yigitakyol1/EE463-Hardware-Project-Team-5/final_report_figures/D1_output1.png

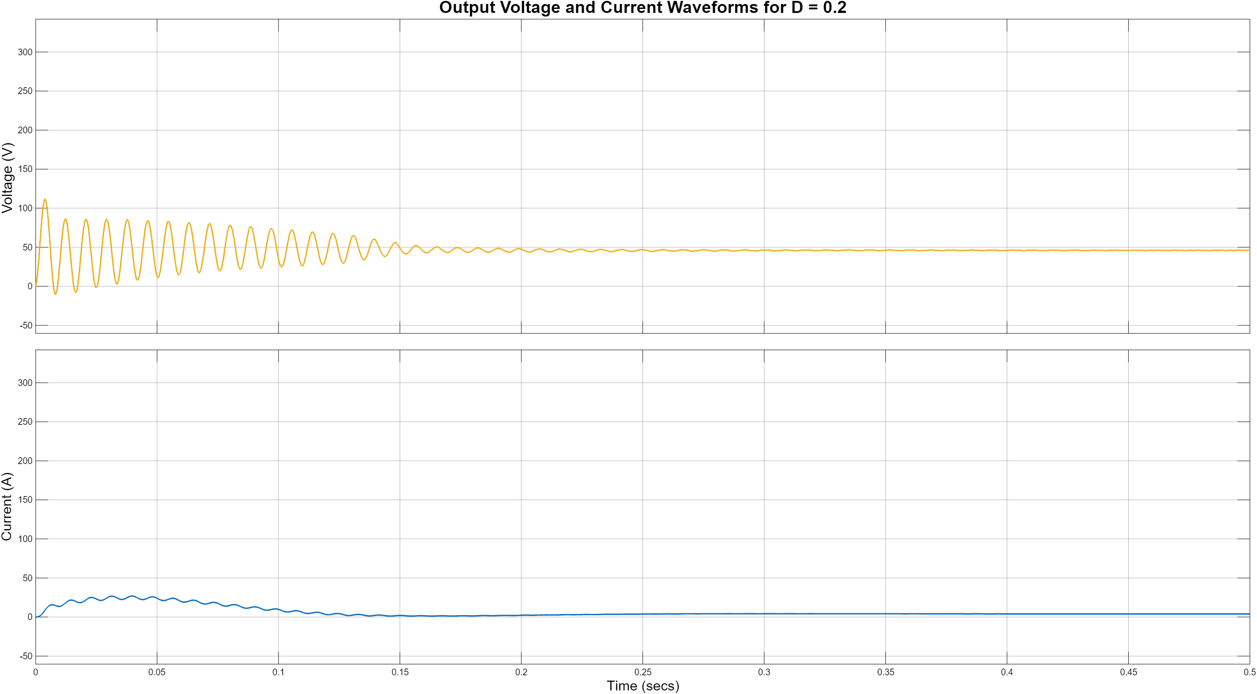
final_report_figures/D1_output1.png
