yigitakyol1/EE463-Hardware-Project-Team-5/final_report_figures/D2_output.png

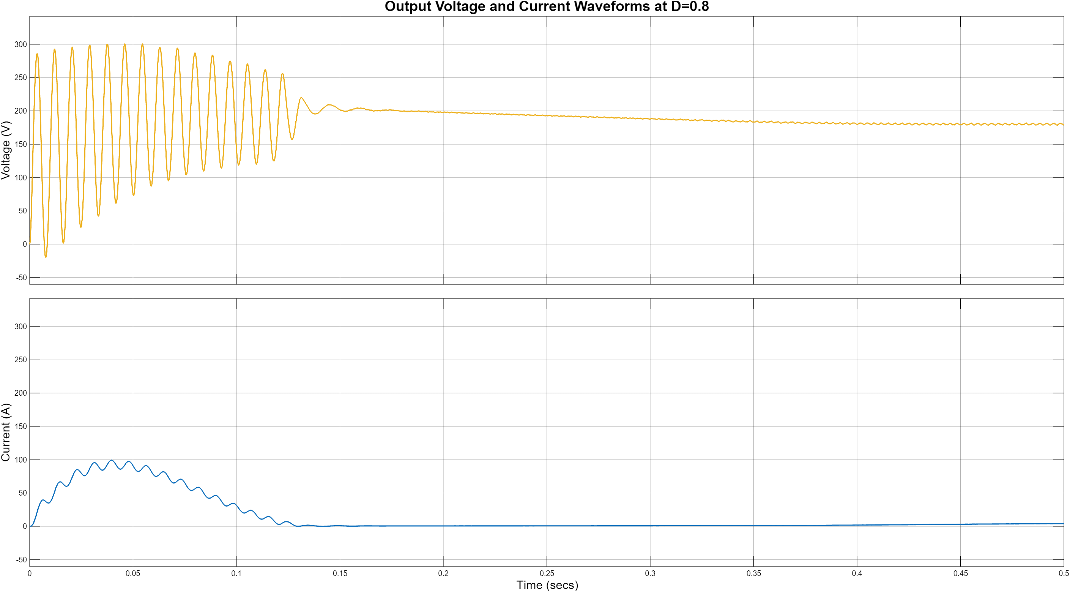
final_report_figures/D2_output.png
