yigitakyol1/EE463-Hardware-Project-Team-5/final_report_figures/IGBT_D2_SS.png

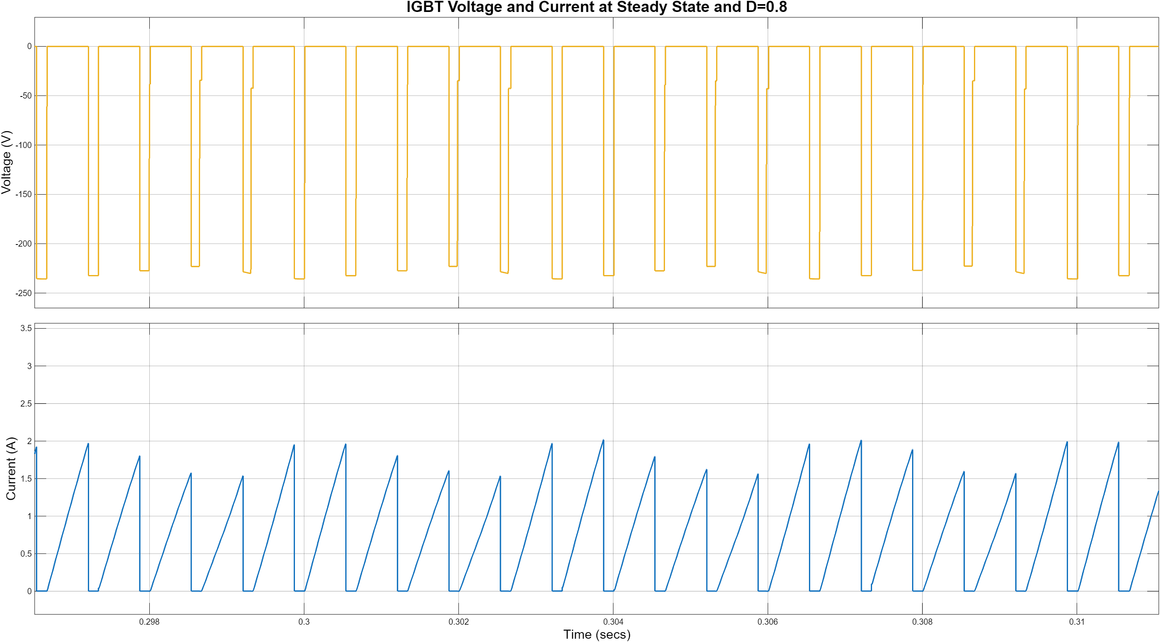
final_report_figures/IGBT_D2_SS.png
