yigitakyol1/EE463-Hardware-Project-Team-5/final_report_figures/IGBT_T_D1.png

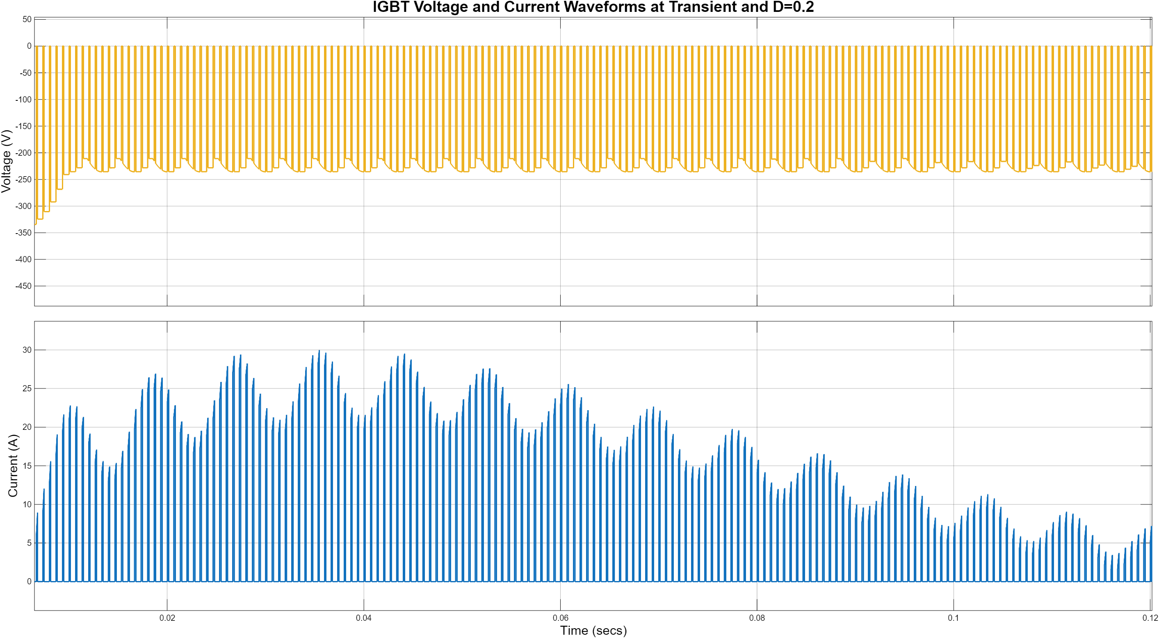
final_report_figures/IGBT_T_D1.png
