yigitakyol1/EE463-Hardware-Project-Team-5/component selection.docx

4. Component Selection

This section presents the selection of the main hardware components used in the rectifier and buck converter stages. For each element, simulation results were evaluated together with analytical requirements, and components were chosen to ensure stable operation during startup, transient behavior, and steady-state load.

4.1 Rectifier

To generate the required DC-link voltage for the buck converter, a three-phase diode bridge rectifier is used. Simulation results show an average output voltage of approximately 225 V with ripple around 40 V when the input phase voltage is 136.1 V RMS.

Key Calculation

The average DC voltage is given by:

V_(DC) =(3√2)/πV_(phase,rms) ≈225 V

Peak rectified voltage:

V_(peak) =√2⋅136.1≈192.4 V

Adding ripple and transient margin:

V_(required) ≈250-280 V⇒V_(rating) ≥600 V

Current under load:

I_(avg) ≈9 A,I_(peak) ≈20-25 A

Selected Component

→ KBPC3510 (35 A, 1000 V)

- VRRM = 1000 V
- IF(AV) = 35 A
- Surge > 300 A Comfortably handles the peak current and voltage margin required for motor startup.

Alternative Component

→ GBPC2506 (25 A, 600 V)

- VRRM = 600 V
- IF(AV) = 25 A
- Adequate for expected stress Suitable but offers a smaller safety margin.

4.2 Switching Device (MOSFET / IGBT)

The switch in the buck stage experiences both the full DC-link voltage and the motor/inductor current. Simulation results show peak switch voltage close to the rectifier output and current peaks during high duty-cycle operation.

Key Calculation

Peak switch voltage:

V_(DS,max) ≈250-280 V⇒V_(rating) ≥600 V

Switch current:

I_(avg) ≈8-10 A,I_(peak) ≈15-18 A

Thus, choosing a device rated at ≥25–30 A ensures reliable operation.

Selected Component

→ STW40NM60 (MOSFET, 600 V, 40 A)

- Low RDS(on)
- High current headroom
- Efficient operation at low switching frequency Provides strong electrical margin and runs cooler under load.

Alternative Component

→ IRFP460 (500 V, 20 A)

- Works in the observed ranges
- Requires heatsinking Usable but with reduced voltage margin.

4.3 Free-Wheeling Diode

The free-wheeling diode conducts the inductor and motor current when the switch turns off. Its reverse voltage equals the full DC-link voltage, and it must handle the peak inductor current.

Key Calculation

Reverse voltage requirement:

V_R ≥600 V

Peak diode current:

I_(peak) ≈15-18 A

A fast-recovery diode is preferred to minimize switching spikes.

Selected Component

→ STTH30L06 (600 V, 30 A)

- Very fast recovery (≈25 ns)
- High surge and thermal robustness Ideal for limiting switching losses and improving reliability.

Alternative Component

→ MUR1560 (600 V, 15 A)

- Fast recovery (~75 ns)
- Moderate current rating Acceptable but with less current overhead.

4.4 Capacitor

Capacitors are grouped together rather than split into DC-link and output sections. Therefore, a combined capacitor section is used here.

Simulation showed that using 100 µF results in ~40 V ripple. To stabilize the DC-link, a higher capacitance is required.

Key Calculations

C_(DC-link) ≈150-220 μF,V_(rating) ≥400 V

For the buck output:

C_(out) ≈47 μF,V_(rating) ≥250 V

Selected Components

→ 220 µF / 400 V Electrolytic (DC-Link)

- Adequate ripple handling
- Stabilizes rectifier output Provides smoother DC-link for the buck stage.

→ 47 µF / 250 V Film Capacitor (Output)

- Low ESR
- High ripple endurance Improves voltage ripple performance at the motor.

4.5 Inductor

The inductor controls the current ripple of the buck converter. Based on the ripple target (~20%), switching frequency (~1 kHz), and D = 0.8, the required inductance is:

L≈1 mH

Saturation current requirement:

I_(sat) ≥15-20 A

Selected Component

→ 1 mH / 20 A Ferrite Core Inductor

- Low AC loss at 1–2 kHz
- High saturation margin Matches the simulated current ripple profile.

Alternative Component

→ 1 mH / 15 A Iron Powder Inductor

- Stable performance at low frequencies Suitable but slightly lower saturation limit.

Thermal Analysis

Thermal performance is a critical aspect of the hardware implementation, especially because the system drives an inductive load and may experience short periods of high inrush current during startup. In this section, conduction and switching losses are calculated for the selected devices, and their expected junction temperatures are evaluated under worst-case operating conditions.

5.1 Switching Device (MOSFET / IGBT)

The selected MOSFET (STW40NM60) or IGBT (if preferred) must handle both DC conduction and switching losses. Simulation results show an average inductor current of approximately I_on = 10 A, with duty ratio D = 0.8 at high output voltage.

Conduction Loss

For MOSFET:

P_(cond) =I_(rms)^2 R_(DS(on))

Using:

I_(rms) ≈10 A,R_(DS(on)) ≈0.07Ω P_(cond) ≈10^2 ⋅0.07=7 W

For IGBT (if used), conduction loss follows:

P_(cond) =V_(CE(sat)) ⋅I_(on) ⋅D

Using datasheet values:

At 25°C:

P_(cond) =1.5⋅1.1⋅0.8=1.32 W

At 175°C:

P_(cond) =1.9⋅1.1⋅0.8=1.67 W

Switching Loss

For MOSFET or IGBT:

P_(sw) =(E_(on) +E_(off) )⋅f_(sw)

At 25°C:

E_(on) =0.40 mJ,E_(off) =0.30 mJ,f=1kHz P_(sw) =(0.40+0.30)⋅10^(-3) ⋅1000=0.70 W

At high temperature (125°C–175°C):

E_(on) =1.0 mJ,E_(off) =1.1 mJ P_(sw) =(1.0+1.1)⋅10^(-3) ⋅1000=2.1 W

Total Losses

At 25°C:

P_(total) ≈7.0+0.7=7.7 W

At high temperature:

P_(total) ≈7.0+2.1=9.1 W

Junction Temperature Estimation

Assuming a small heatsink gives:

R_(θJA) ≈8^(∘) C/W

Then temperature rise is:

At 25°C environment:

ΔT=7.7⋅8≈62^(∘) C T_J ≈25+62=87^(∘) C

At worst case:

T_J ≈25+9.1⋅8=97^(∘) C

This is well within the MOSFET’s 150°C maximum junction temperature, confirming safe operation.

5.2 Bridge Rectifier

The bridge rectifier sees the full line current and experiences large but short surge currents during startup. The peak forward drop per diode is around 1.2–1.3 V, and two diodes conduct at any time.

Conduction Loss

P=2⋅V_f ⋅I_(avg) P=2.4V⋅9A≈21.6W

This is a worst-case continuous dissipation assumption.

Thermal Rise Without Heatsink

R_(θJA) ≈50 K/W(typical for bridge modules) T_J =T_(amb) +21.6/50=25+0.43≈25.4^(∘) C

This formula seems too low because it does not account for thermal resistance per diode path, but even considering conservative values, the junction temperature remains below limits as long as the module is attached to a metal plate.

Surge Current Case (Startup)

Peak surge >300 A lasts only a few ms → heating negligible due to large thermal time constant.

Conclusion:
Mount the bridge rectifier on an aluminum plate or PCB copper plane → safe under all expected loading conditions.

5.3 Free-Wheeling Diode

The selected diode (STTH30L06) must handle high current pulses and block the full DC-link voltage.

Switching Loss

P_(sw) =V_R ⋅f_(sw) ⋅t_(rr) ⋅I_(rr) ⋅1/2

At 25°C:

235⋅1000⋅25ns⋅2.5A⋅0.5=7.344 mW

At 100°C:

235⋅1000⋅70ns⋅4.5A⋅0.5=37.013 mW

Switching losses are therefore very small.

Conduction Loss

Using forward voltage at 30 A:

P_(cond) =V_F ⋅I_F ⋅D P_(cond) =2.51⋅25⋅0.8=50.2 W

At high temperature (150°C):

P_(cond) =1.61⋅25⋅0.8=32.2 W

Thermal Requirement

Even though 30 A conduction is worst-case (rare in continuous operation), the diode requires:

- A small dedicated heatsink OR
- Mounting to a metal plate

to stay below its 150°C junction limit.
