yigitakyol1/EE463-Hardware-Project-Team-5/(commit log)

2025-12-04 Simulations and Report Update
    In this commit, simulations and figures for the three phase diode rectifier are given in the report and commented on. Also, simulation schematic is shared for buck converter, which is still in progress.
2026-01-18 Final Commit for figures, datasheets etc.
    In this commit, the simulations are finalized and figures are committed. Datahssets are also committed. Arduino code for soft start is also shared.
